roanshdesai/OilSense/images/edited/front-view_white.png

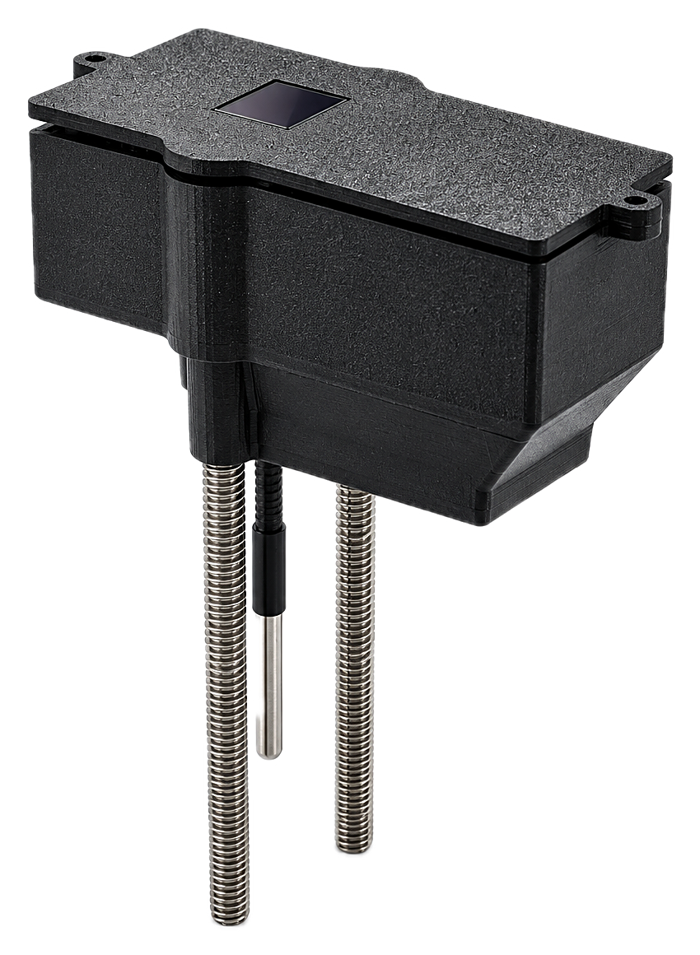
images/edited/front-view_white.png
