roanshdesai/OilSense/docs/iris_submission/figures/p_photos.png

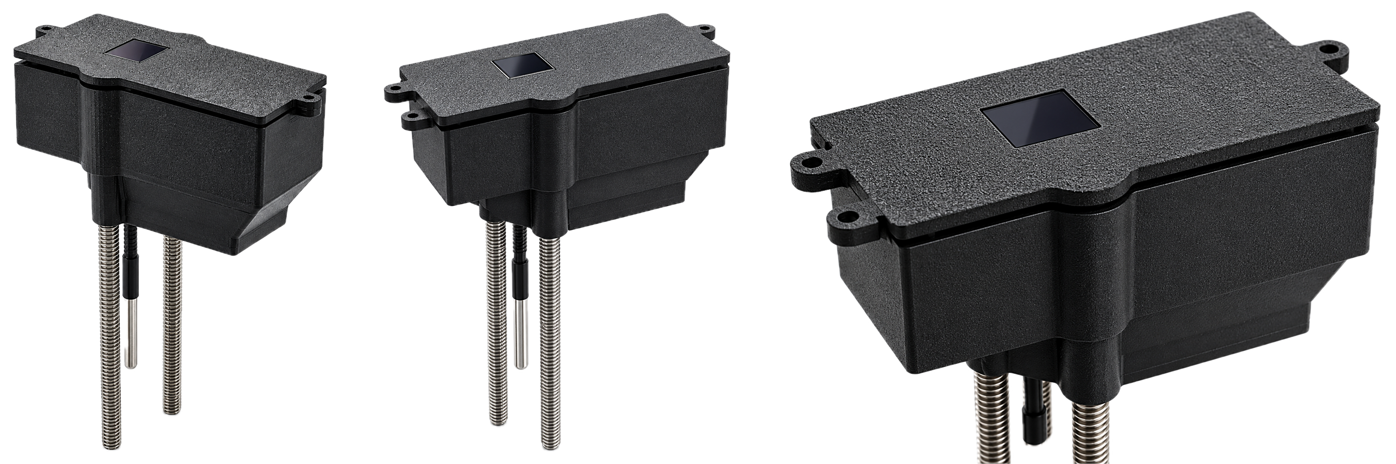
docs/iris_submission/figures/p_photos.png
