roanshdesai/OilSense/docs/iris_submission/figures/fig_cap_budget.png

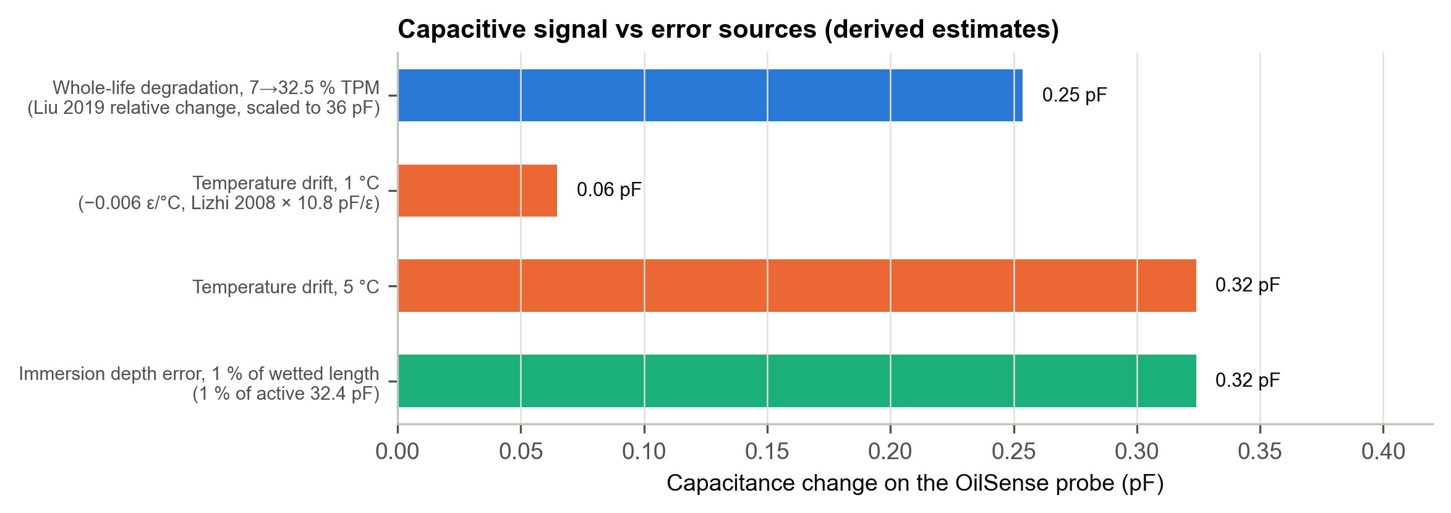
docs/iris_submission/figures/fig_cap_budget.png
