roanshdesai/OilSense/docs/iris_submission/figures/fig_tpc_vs_hours.png

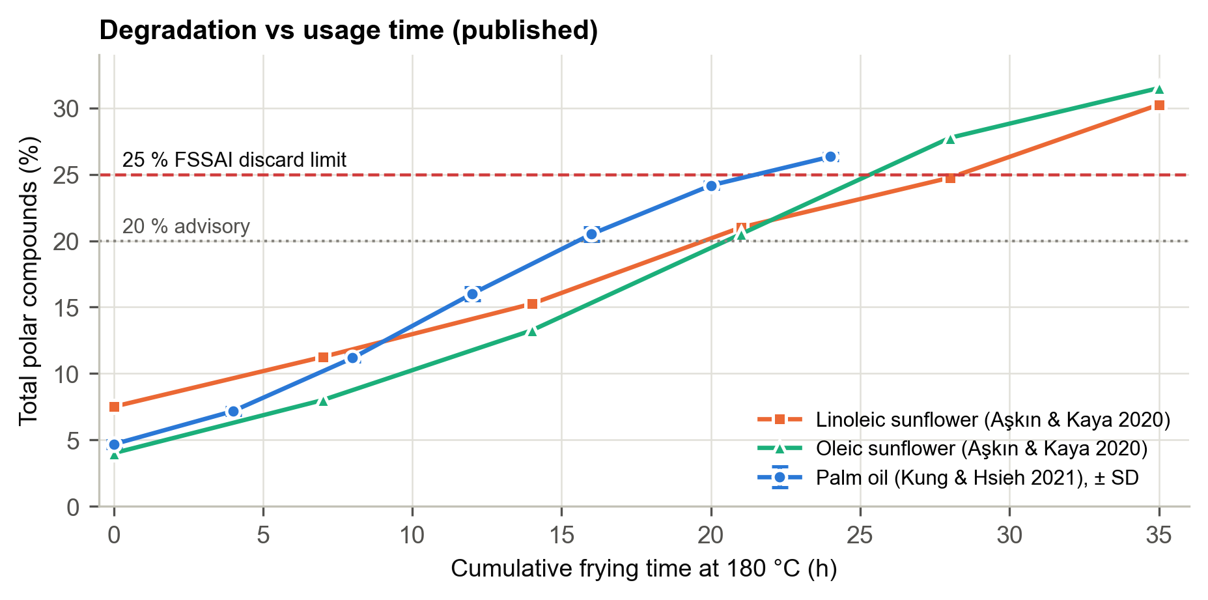
docs/iris_submission/figures/fig_tpc_vs_hours.png
