roanshdesai/OilSense/images/edited/closeup_transparent.png

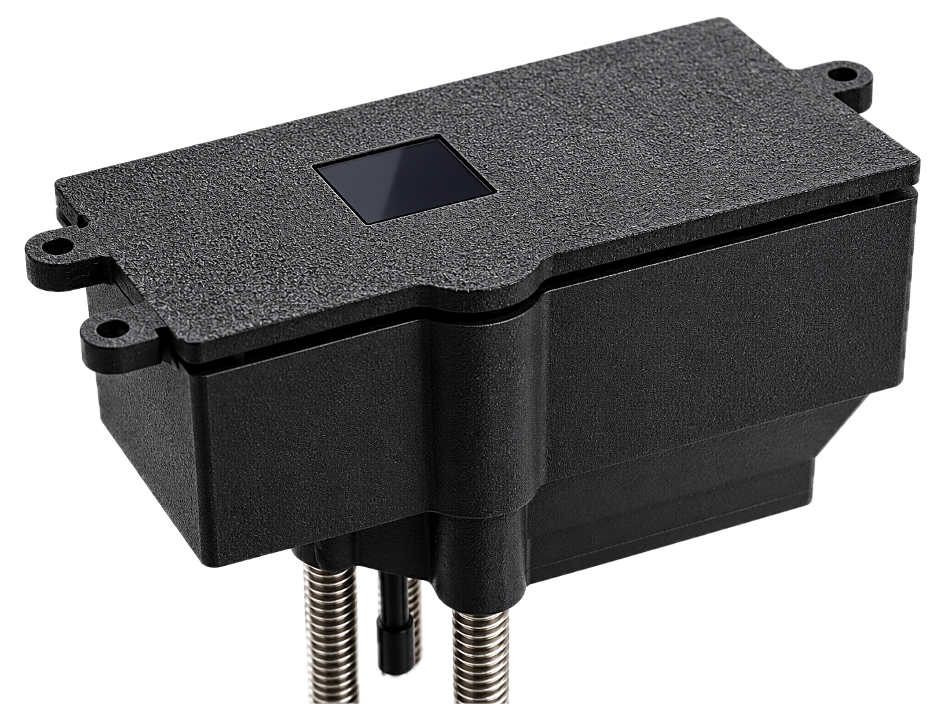
images/edited/closeup_transparent.png
