roanshdesai/OilSense/images/edited/opposite-view_transparent.png

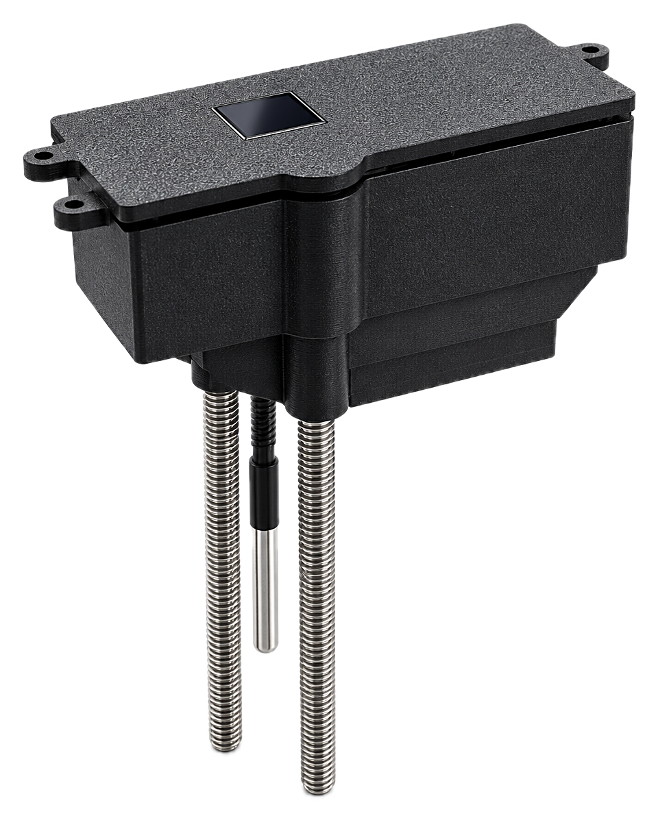
images/edited/opposite-view_transparent.png
