roanshdesai/OilSense/images/edited/raw-prototype_transparent.png

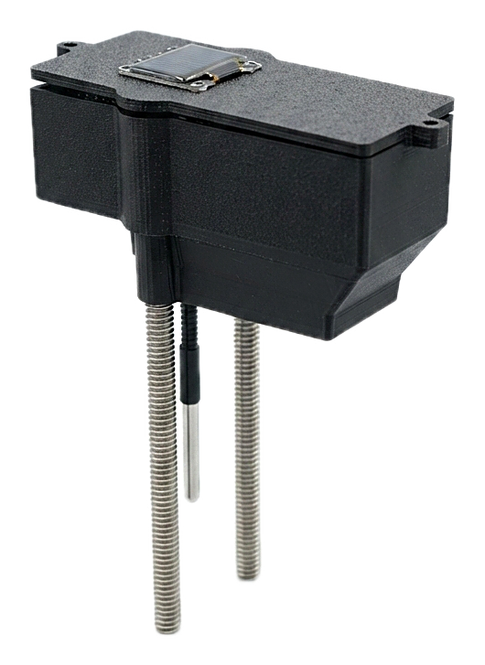
images/edited/raw-prototype_transparent.png
