roanshdesai/OilSense/images/original/flush-screen-closeup.png

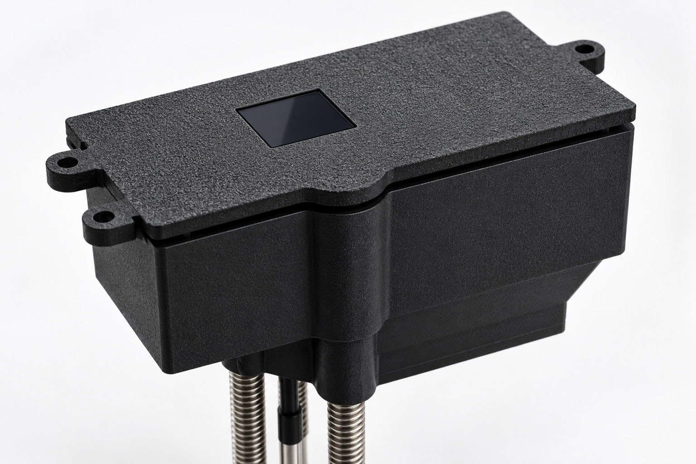
images/original/flush-screen-closeup.png
