roanshdesai/OilSense/images/original/front-view.png

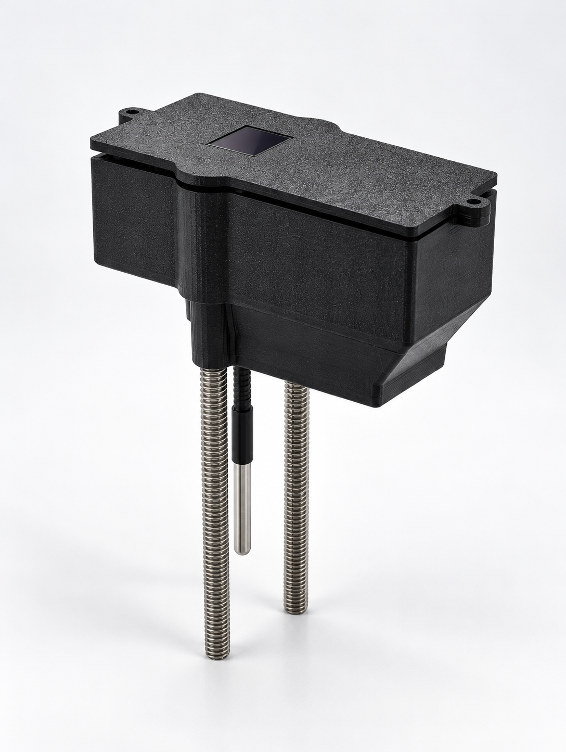
images/original/front-view.png
