roanshdesai/OilSense/images/original/opposite-view.png

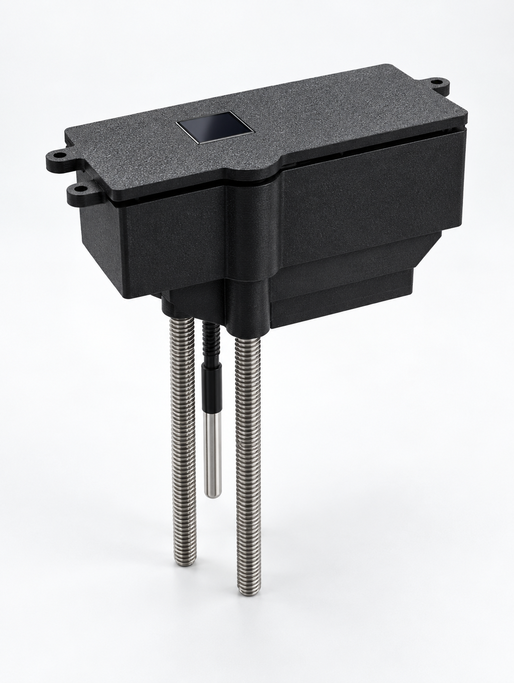
images/original/opposite-view.png
