roanshdesai/OilSense/images/original/prototype-raw.png

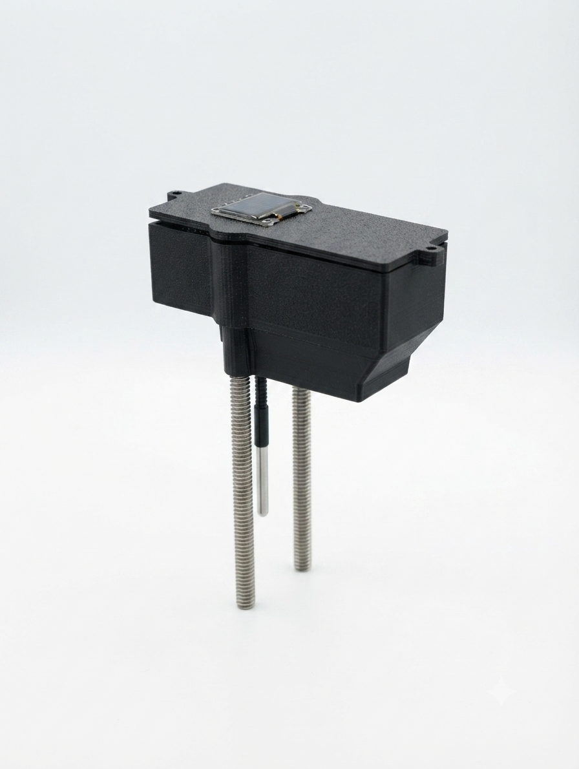
images/original/prototype-raw.png
