roanshdesai/OilSense/(commit log)

2026-08-09 Initial import: OilSense dual-channel frying-oil degradation meter
    Firmware (bench + field), dashboard, stub-header verification tooling,
    technical disclosure, and the CLAUDE.md / CALIBRATION.md context files.
2026-09-22 Fix AS7265x channel-order bug and three acquisition defects
    SparkFun's channel letters are not in wavelength order. Verified against the
    library's own Example1_BasicReadings header:
    A,B,C,D,E,F,G,H,R,I,S,J,T,U,V,W,K,L
    Reading them A..L then R..W and labelling that 410->940 mislabelled every
    channel from 610 nm up. CH_NIR=17 was documented as 940 nm but was actually
    W=860 nm, so every lambda fitted so far is 435/860. Added a verified SRC[]
    permutation and remapped on read; CH_NIR stays on 860 nm so the existing
    OPT_FRESH/OPT_DISCARD remain valid.
    Uploads now carry "ch_order":"asc_410_940". Records written before this are in
    letter order and the absent field is what identifies them - wi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
    [OilSense_Bench.ino, OilSense_Field.ino]
2026-09-22 Add IRIS National Fair deck and 90-second presentation script
    11-slide deck plus a three-part script timed at 89.8 s of a 90 s slot:
    40 s slides, 30 s live demo, 20 s slides. Word counts measured, not estimated.
    Script also carries a demo rehearsal checklist, a scripted recovery if the
    reading does not move, and a prep sheet of the questions judges reliably ask.
    The 860 nm figure on the results slide reflects the channel-map fix in the
    previous commit - it was the mislabelled 940 nm.
    Deck working copies (*.backup.pptx, *.prev.pptx) are gitignored.
2026-09-22 Move the database endpoint out of tracked files
    Prepares the repo to be made public. WIFI_SSID, WIFI_PASSWORD and DB_HOST now
    live in a per-sketch secrets.h which is gitignored; secrets.h.example is
    committed as the template. The dashboard reads window.OILSENSE_DB from a
    gitignored config.js, with config.example.js as the template, and falls back to
    demo data when it is absent.
    tools/secrets.h is a stub so tools/check.sh still compiles the sketches without
    a real endpoint present.
    NOTE: a Firebase RTDB URL is not really a secret - it ships in any client. The
    control that matters is the database rules. They are currently open
    (.read/.write true) and must be locked before this repo is public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
2026-09-22 Carry the channel-order fix into the dashboard, docs and bench data
    Dashboard: normalise() now remaps legacy records into ascending wavelength
    order, so the ratio, the spectrum chart and the CSV export all agree. Records
    carrying ch_order:"asc_410_940" pass through untouched; anything without that
    field is pre-fix and gets the SRC[] permutation applied once, at ingest.
    CH_NIR moves 17 -> 15, matching the firmware: letter-index 17 was 860 nm all
    along, and every calibration constant was fitted against it.
    CLAUDE.md: the fourth survival figure was recorded as 940 nm and was always
    860 nm; the first three were unaffected. Added the bug to the do-not-reintroduce
    table as #11, documented ch_orde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
    [oilsense_probe-01_2026-08-07.csv, oilsense_probe-01_2026-08-09.csv]
2026-10-13 Add IRIS research paper, synopsis, figures and prototype photos
    docs/iris_submission holds the anonymous research paper and synopsis
    (PDF and DOCX) and every paper figure as PNG/SVG. images/ holds the
    original prototype photos and background-removed versions.
